joeelbeltagy-rgb/Mechanical-7-Segment-Display-Clock-Using-Arduino-and-Servo-Motors/3d-models/dc_shoe_a.stl

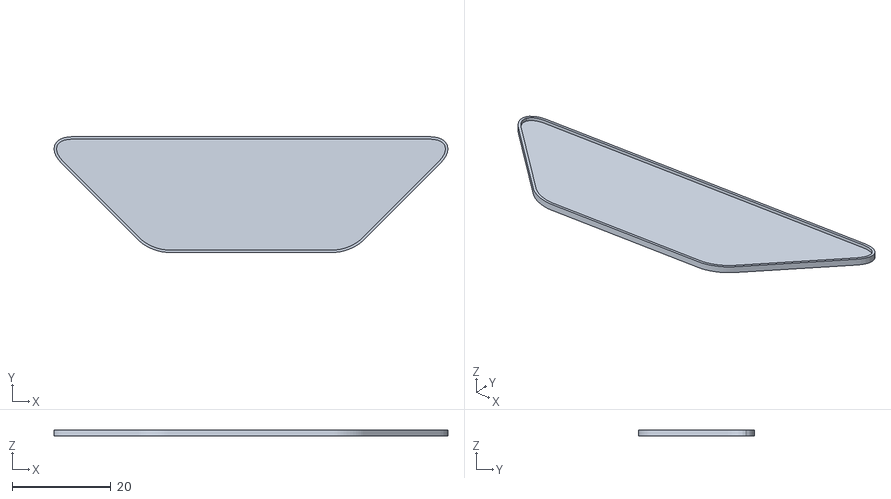
[picture p6: CAD file, 2026-06-04]
3d-models/dc_shoe_a.stl
79.7 x 23.4 x 1.20
