joeelbeltagy-rgb/Mechanical-7-Segment-Display-Clock-Using-Arduino-and-Servo-Motors/3d-models/dc_shoe_b.stl

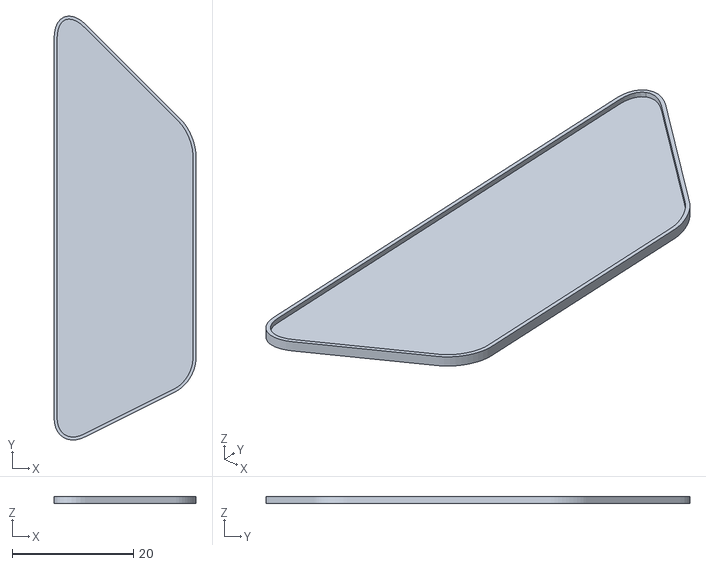
[picture p7: CAD file, 2026-06-04]
3d-models/dc_shoe_b.stl
23.4 x 69.9 x 1.20
