joeelbeltagy-rgb/Mechanical-7-Segment-Display-Clock-Using-Arduino-and-Servo-Motors/3d-models/dc_base1.stl

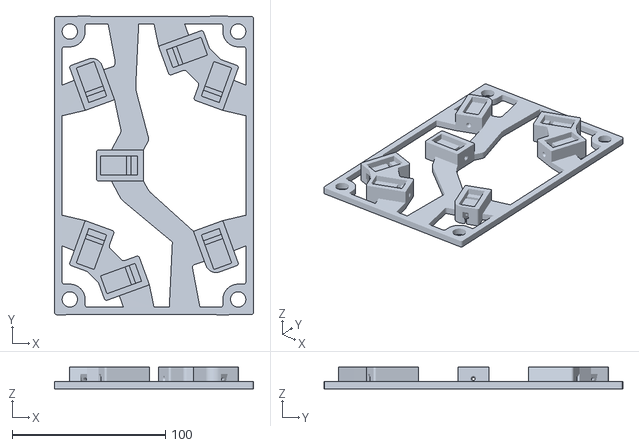
[picture p8: CAD file, 2026-06-04]
3d-models/dc_base1.stl
130.0 x 195.0 x 14.3
