joeelbeltagy-rgb/Mechanical-7-Segment-Display-Clock-Using-Arduino-and-Servo-Motors/3d-models/dc_frame_bottom.stl

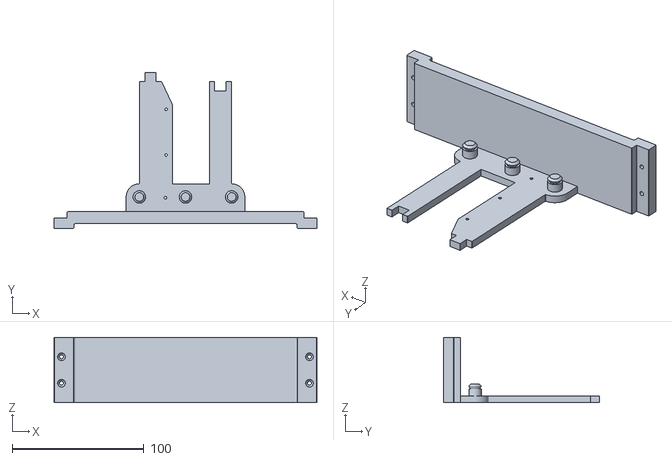
[picture p9: CAD file, 2026-06-04]
3d-models/dc_frame_bottom.stl
199.5 x 118.5 x 49.6
