joeelbeltagy-rgb/Mechanical-7-Segment-Display-Clock-Using-Arduino-and-Servo-Motors/3d-models/dc_segment_c.stl

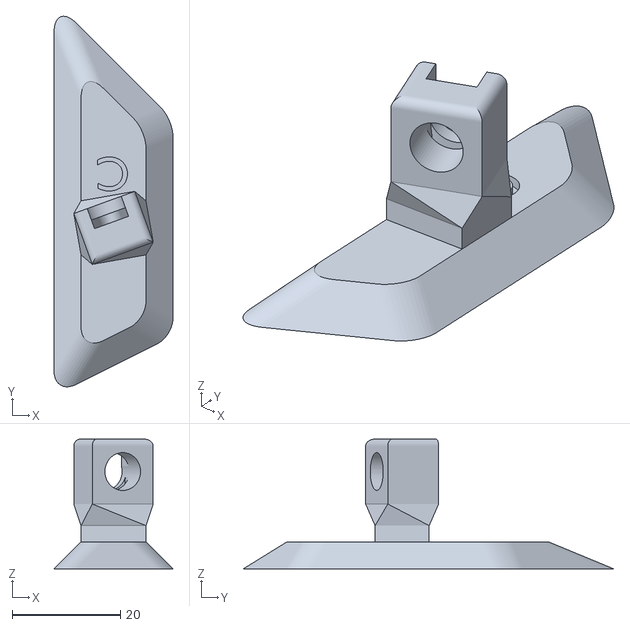
[picture p10: CAD file, 2026-06-04]
3d-models/dc_segment_c.stl
22.0 x 68.5 x 24.0
