joeelbeltagy-rgb/Mechanical-7-Segment-Display-Clock-Using-Arduino-and-Servo-Motors/3d-models/dc_frame_top.stl

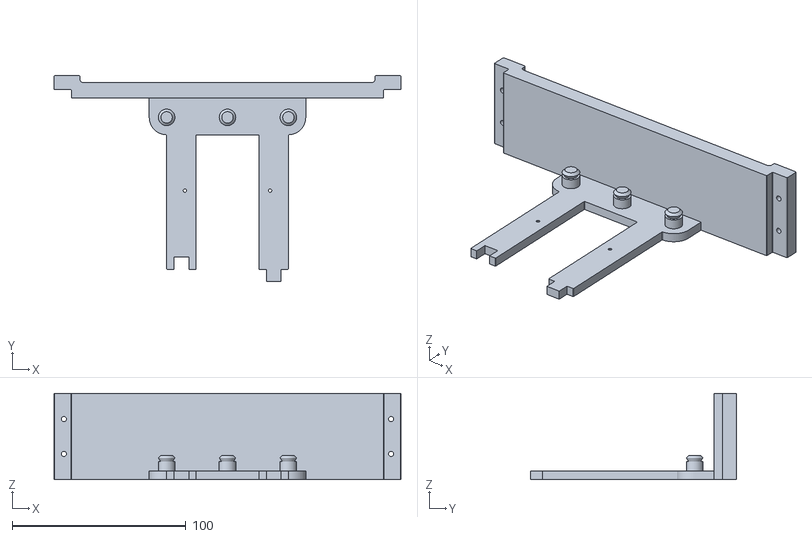
[picture p11: CAD file, 2026-06-04]
3d-models/dc_frame_top.stl
199.5 x 118.3 x 49.6
