joeelbeltagy-rgb/Mechanical-7-Segment-Display-Clock-Using-Arduino-and-Servo-Motors/3d-models/dc_frame_corner2.stl

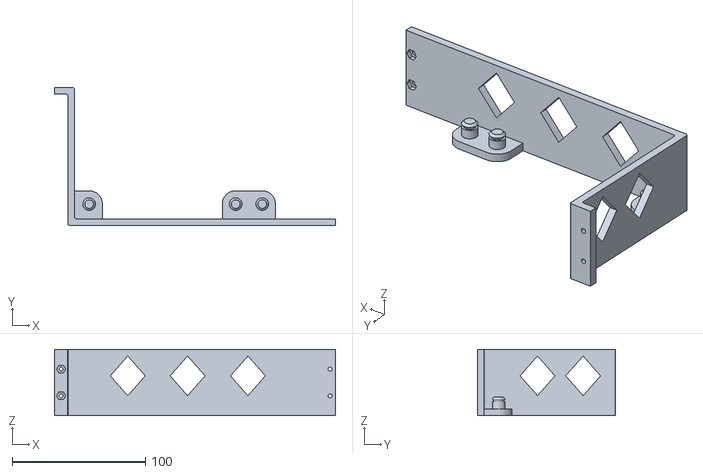
[picture p13: CAD file, 2026-06-04]
3d-models/dc_frame_corner2.stl
211.0 x 103.5 x 49.6
