joeelbeltagy-rgb/Mechanical-7-Segment-Display-Clock-Using-Arduino-and-Servo-Motors/3d-models/dc_base_center.stl

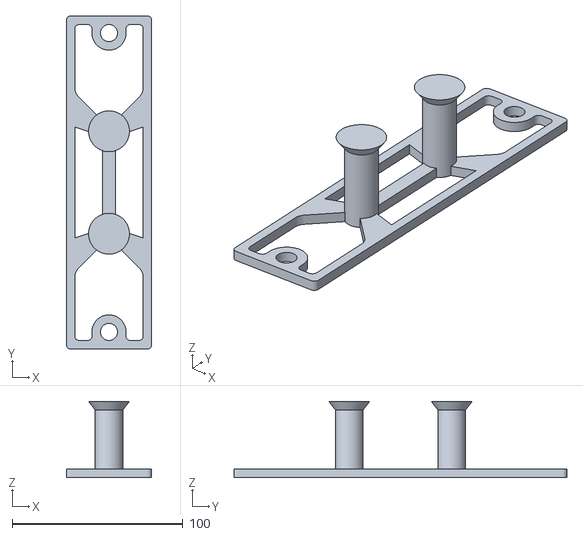
[picture p14: CAD file, 2026-06-04]
3d-models/dc_base_center.stl
50.0 x 195.0 x 44.6
