joeelbeltagy-rgb/Mechanical-7-Segment-Display-Clock-Using-Arduino-and-Servo-Motors/3d-models/dc_segment_g.stl

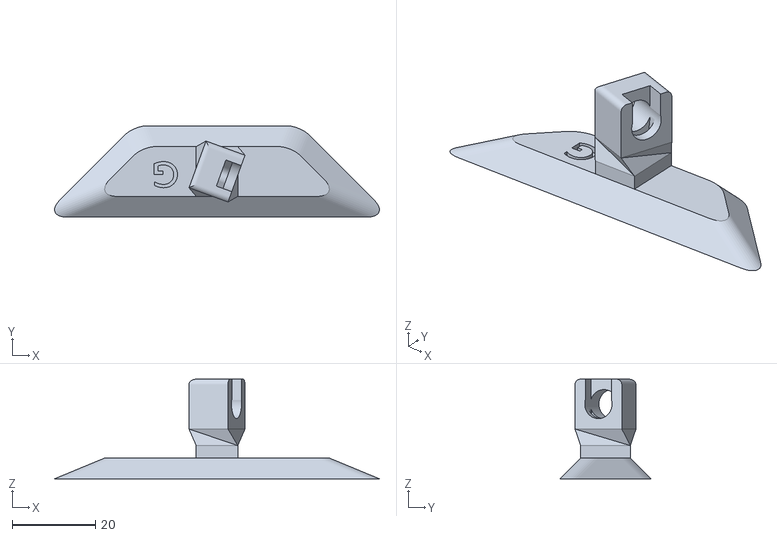
[picture p15: CAD file, 2026-06-04]
3d-models/dc_segment_g.stl
78.3 x 22.0 x 24.0
