joeelbeltagy-rgb/Mechanical-7-Segment-Display-Clock-Using-Arduino-and-Servo-Motors/3d-models/dc_shoe_center.stl

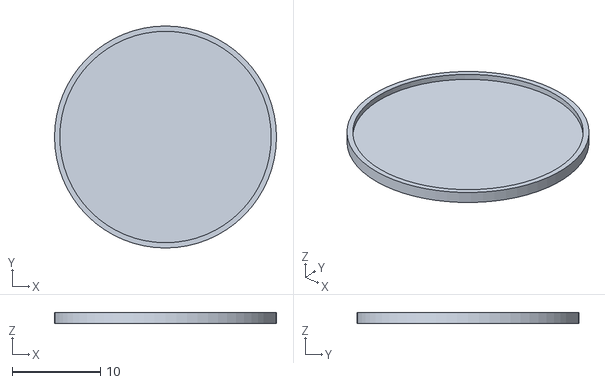
[picture p16: CAD file, 2026-06-04]
3d-models/dc_shoe_center.stl
25.1 x 25.1 x 1.20
