joeelbeltagy-rgb/Mechanical-7-Segment-Display-Clock-Using-Arduino-and-Servo-Motors/3d-models/dc_segment_d.stl

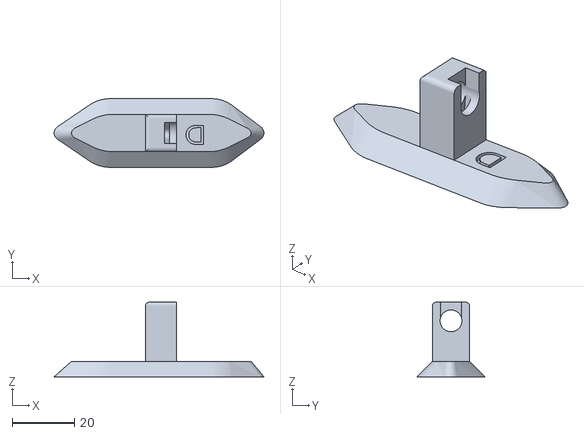
[picture p17: CAD file, 2026-06-04]
3d-models/dc_segment_d.stl
67.4 x 22.0 x 24.0
