joeelbeltagy-rgb/Mechanical-7-Segment-Display-Clock-Using-Arduino-and-Servo-Motors/(list of files, cad)

Other CAD files:
3d-models/dc_shoe_e.stl
3d-models/dc_shoe_c.stl
3d-models/dc_shoe_g.stl
3d-models/dc_shoe_f.stl
3d-models/dc_segment_e.stl
3d-models/dc_segment_b.stl
3d-models/dc_segment_a.stl
3d-models/dc_segment_f.stl
3d-models/dc_frame_corner1.stl
3d-models/dc_base.stl
3d-models/dc_washer.stl
